trungnguyendx/Remote-Control-by-DTMF/(list of files, drawings)

Other design files:
PCB.pdsprj
Simulation.pdsprj
