trungnguyendx/Remote-Control-by-DTMF/(commit log)

2020-11-18 fix: dtmf device
2020-11-29 build: DTMF remote control
    [BTL HE THONG NHUNG PCB_TRIAC.pdsprj, BTL HE THONG NHUNG.pdsprj]
2020-11-30 final commit
    [Components.xlsx, PCB.pdsprj, Simulation.pdsprj]
